arthurlleite/lulu-alimentador/documentacao/imagens/site-conectar.png

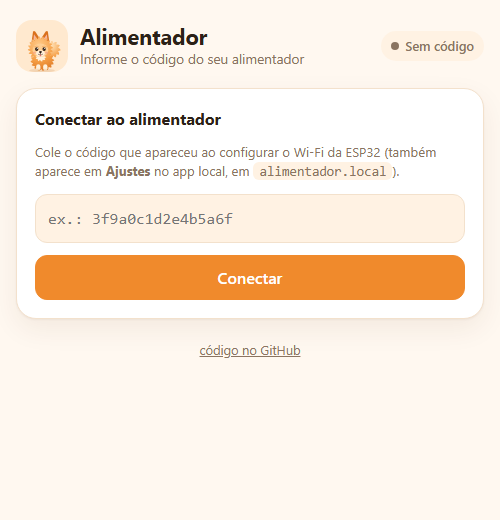
documentacao/imagens/site-conectar.png
