arthurlleite/lulu-alimentador/hardware/3d/imagens/eletronica_furacao.png

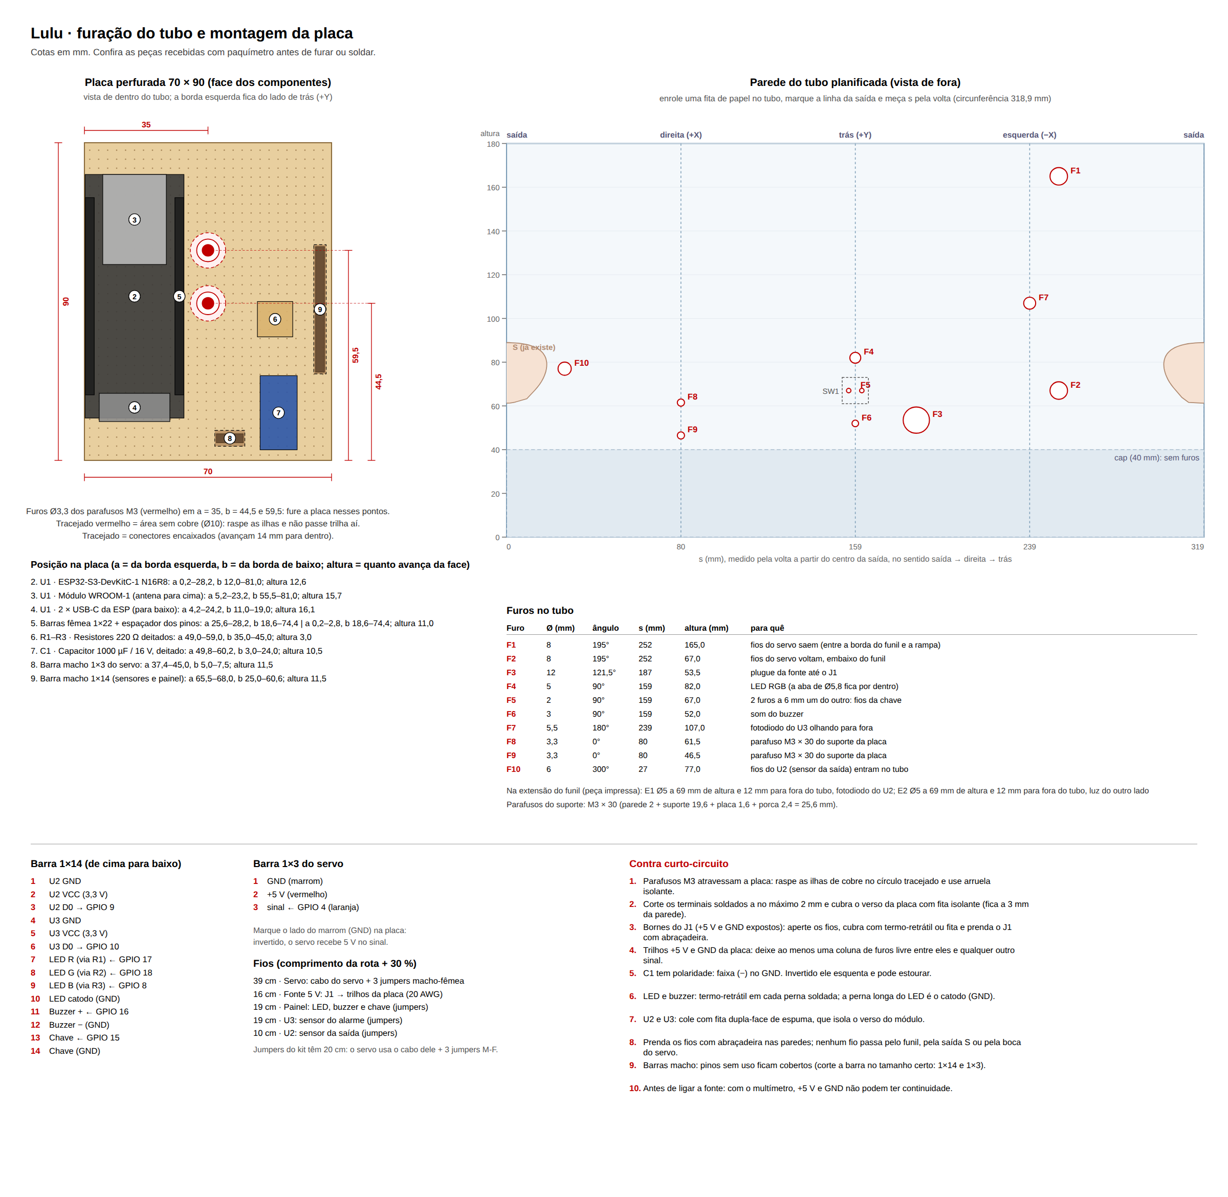
hardware/3d/imagens/eletronica_furacao.png
