arthurlleite/lulu-alimentador/hardware/3d/IoT3D.FCStd

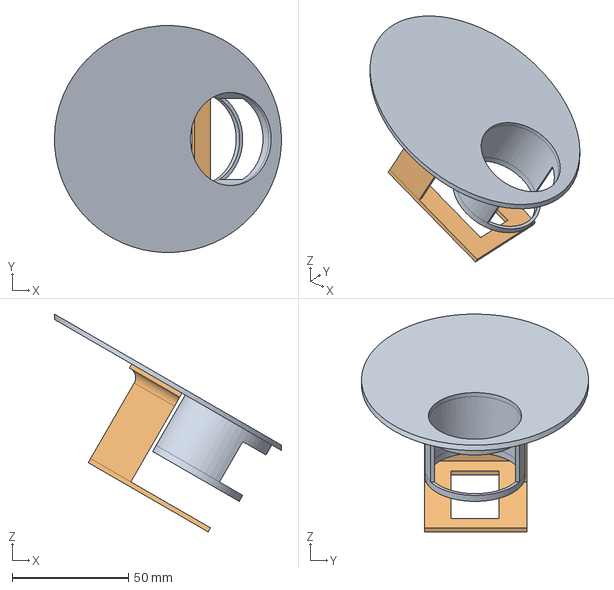
[picture p18: CAD file, 2026-10-22]
hardware/3d/IoT3D.FCStd
97.5 x 97.4 x 93.5 mm
superficie_inclinada
Suporte_motor
