arthurlleite/lulu-alimentador/hardware/3d/stl/tampa_atuador.stl

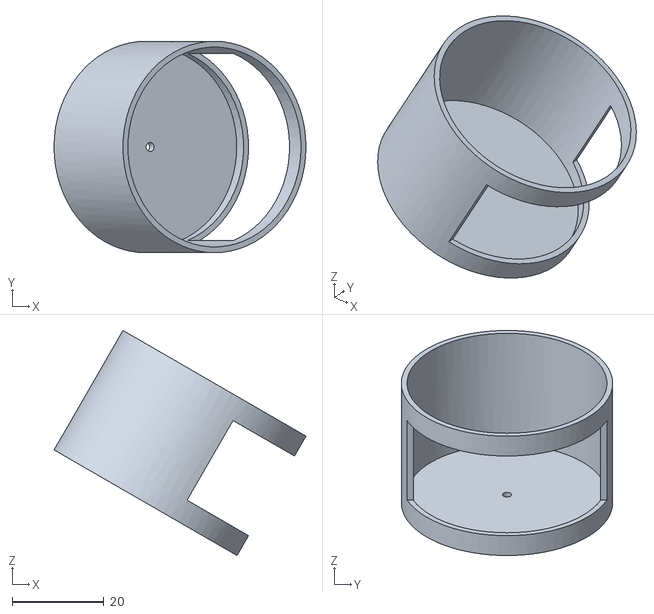
[picture p19: CAD file, 2026-10-22]
hardware/3d/stl/tampa_atuador.stl
54.8 x 46.0 x 49.0
