arthurlleite/lulu-alimentador/hardware/3d/stl/extensao_funil.stl

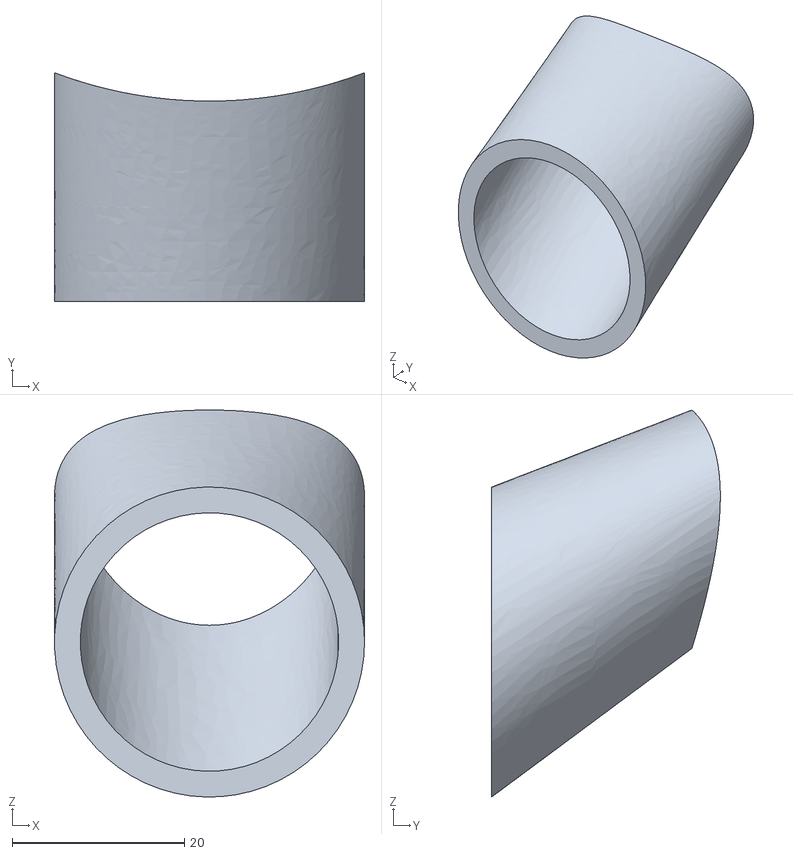
[picture p20: CAD file, 2026-10-22]
hardware/3d/stl/extensao_funil.stl
36.0 x 26.5 x 44.9
