arthurlleite/lulu-alimentador/hardware/3d/stl/funil_interno.stl

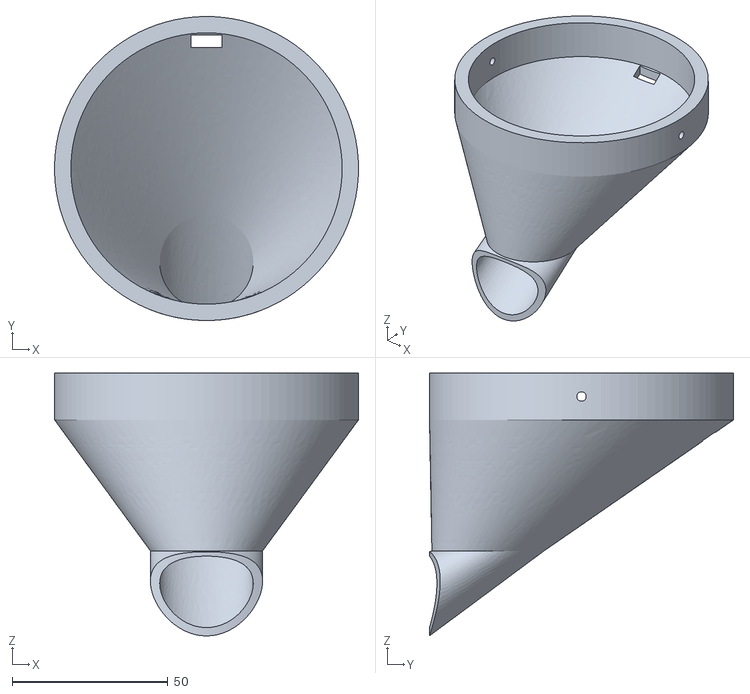
[picture p21: CAD file, 2026-10-22]
hardware/3d/stl/funil_interno.stl
97.5 x 97.5 x 84.3
