arthurlleite/lulu-alimentador/hardware/3d/stl/suporte_placa.stl

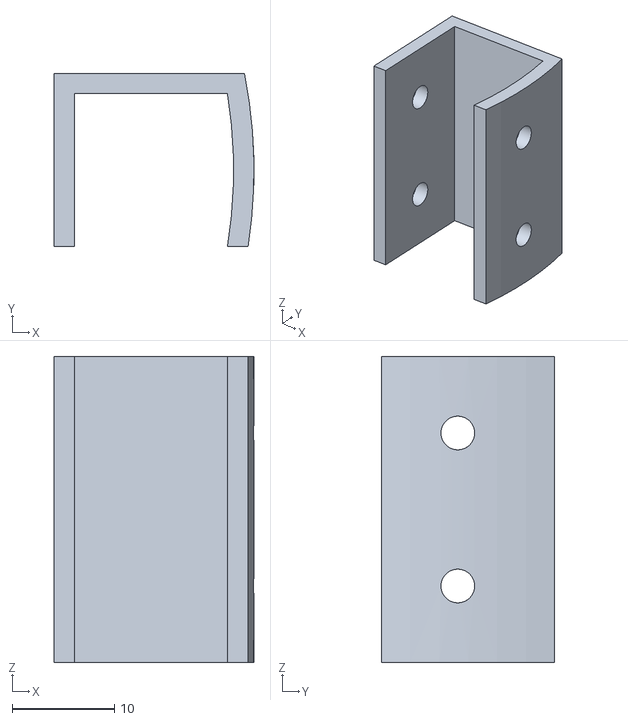
[picture p22: CAD file, 2026-10-22]
hardware/3d/stl/suporte_placa.stl
19.6 x 17.0 x 30.0
