arthurlleite/lulu-alimentador/hardware/3d/stl/suporte_rampa.stl

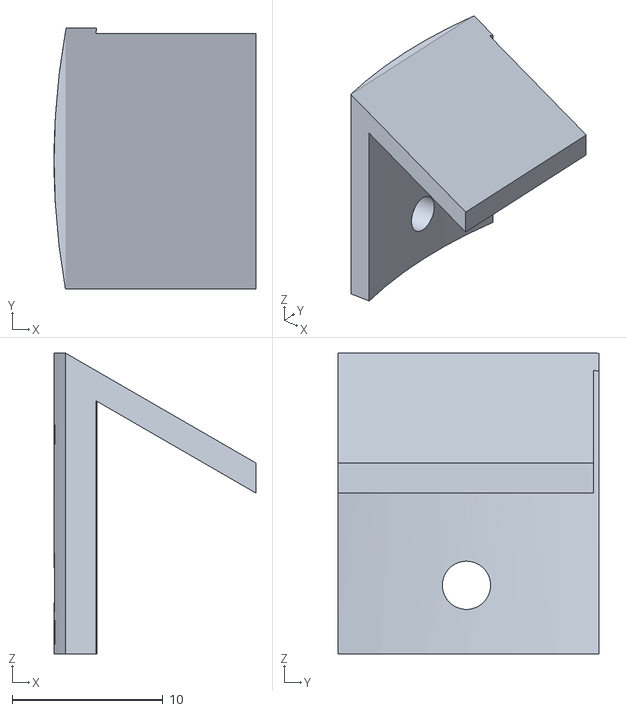
[picture p23: CAD file, 2026-10-22]
hardware/3d/stl/suporte_rampa.stl
13.4 x 17.4 x 20.0
