arthurlleite/lulu-alimentador/hardware/3d/stl/rampa_inclinada.stl

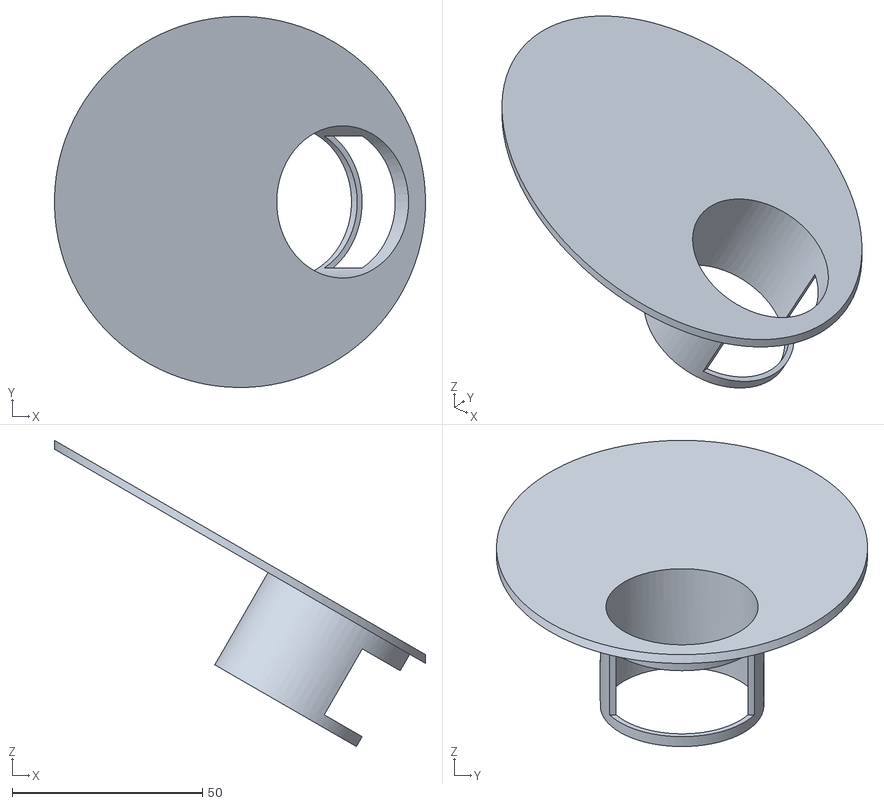
[picture p24: CAD file, 2026-10-22]
hardware/3d/stl/rampa_inclinada.stl
97.5 x 97.5 x 80.4
