arthurlleite/lulu-alimentador/hardware/3d/stl/tampa_tubo.stl

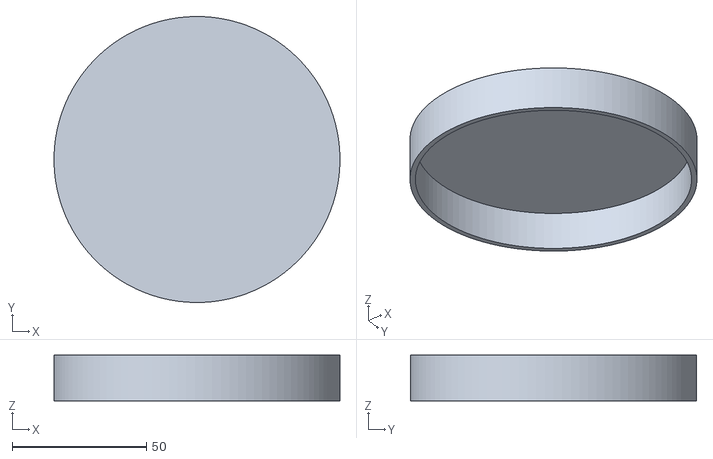
[picture p25: CAD file, 2026-10-22]
hardware/3d/stl/tampa_tubo.stl
106.5 x 106.5 x 17.0
