arthurlleite/lulu-alimentador/hardware/3d/stl/suporte_motor.stl

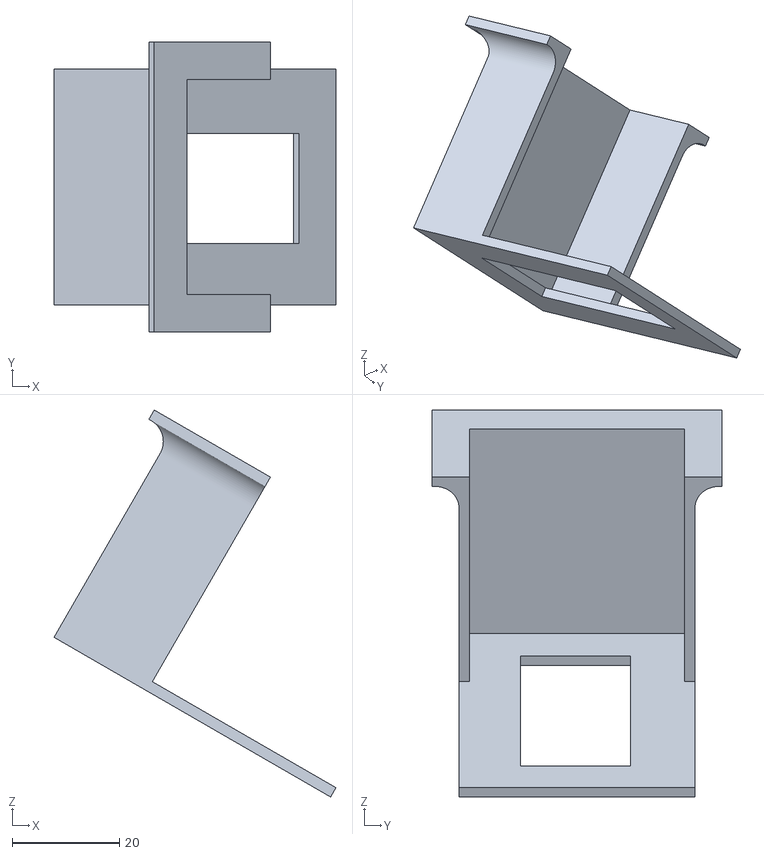
[picture p26: CAD file, 2026-10-22]
hardware/3d/stl/suporte_motor.stl
52.5 x 54.0 x 72.1
