arthurlleite/lulu-alimentador/firmware/src/dns_portal.h

#pragma once
// DNS "cativo": responde qualquer nome com 192.168.4.1 enquanto a rede de
// configuração está ativa, para o celular abrir a página sozinho.
void dns_portal_iniciar(void);
void dns_portal_parar(void);
