arthurlleite/lulu-alimentador/(commit log)

2026-10-22 Organiza o repositório por destino: firmware, web e hardware
    O modelo 3D vai para hardware/3d (o que vai para a impressora fica
    separado do código da ESP32). Remove os READMEs vazios do template do
    PlatformIO e as associações de arquivo do VS Code, e fixa LF como fim
    de linha para os arquivos embutidos no firmware.
2026-10-22 Migra o firmware para ESP-IDF 5 na pasta firmware/
    Base do novo firmware: PlatformIO com ESP-IDF 5.3 (espressif32 6.9.0)
    para ESP32-S3 DevKitC-1 e ESP32 clássica, tabela de partições com app
    de 1,875 MB (o TLS não cabe em 1 MB), pinos e parâmetros no menuconfig
    e o estado central (app.c), que guarda nome do pet, agenda e Wi-Fi na
    NVS e gera o JSON de status.
    Os módulos lib/my_* do projeto original são reescritos nos commits
    seguintes (servo, agenda, sensores e rede).
2026-10-22 Reescreve servo e agenda e adiciona LED RGB, buzzer e botão
    feeder: fila de refeições com struct própria (o original criava a fila
    com itens de 160 bytes e copiava para um int, corrompendo a pilha).
    Cada porção abre e fecha o servo como no my_servo.c, com PWM de 14 bits
    e sensor IR na saída: se nada cair, sacode e tenta de novo, e avisa.
    scheduler: até 8 horários com porções próprias, conferidos por minuto
    (o original dormia um tempo negativo com a agenda vazia).
    ui: LED RGB de status, buzzer que chama o pet antes de servir e botão
    (toque = 1 porção, 5 s = apagar o Wi-Fi).
2026-10-22 Adiciona sensores de nível (HC-SR04) e ambiente (DHT11)
    O ultrassom fica na tampa de cima e mede a distância até a ração
    (mediana de 5 leituras por causa dos ecos no tubo); vira porcentagem
    com a calibração vazio/cheio e gera o alarme de ração baixa. O DHT11
    mede temperatura e umidade dentro do reservatório.
2026-10-22 Reescreve a rede: portal de configuração, MQTT com TLS e app local
    wifi_mgr: sem Wi-Fi salvo, cria a rede Alimentador-XXXX com portal
    cativo (DNS próprio) onde se escolhe a rede e o nome do pet. Com Wi-Fi
    salvo, reconecta com espera crescente e reabre o portal se não
    conseguir. Deixa de imprimir a senha na serial.
    mqtt_link: broker público da HiveMQ via mqtts, tópico com código
    aleatório de 64 bits, estado retido e testamento online/offline. Trata
    o comando na hora em vez de repassar o buffer do cliente para outra
    tarefa.
    web_server: serve o app e a página de configuração embutidos na flash
    e a API /api/state, /api/cmd, /api/scan e /api/provision.
    commands: o mesmo JSON pelo MQ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
2026-10-22 Cria a arte do Lulu da Pomerânia para o ícone do app
    Desenho vetorial (SVG) gerado por tools/lulu.py, com versões PNG de 192
    e 512 px para instalar o app na tela inicial do celular. Substitui as
    imagens do projeto antigo.
2026-10-22 Refaz o app web: painel do pet, agenda e página de configuração
    index.html substitui a página Bootstrap + Paho do Firebase. O mesmo
    arquivo roda em dois modos: servido pela ESP32 (HTTP local, funciona
    sem internet) ou no GitHub Pages (MQTT via WebSocket seguro). Mostra
    nível de ração, próxima refeição, temperatura/umidade, histórico e
    alarmes; a agenda aceita até 8 horários com porções e liga/desliga.
    Tema claro/escuro automático e layout para celular.
    setup.html é a página do portal cativo: nome do pet, lista de redes
    com sinal e senha. No fim mostra o link pessoal de acesso remoto.
    manifest.webmanifest permite instalar como app no celular.
2026-10-22 Publica o app e um instalador de firmware no GitHub Pages
    O workflow compila o firmware das duas placas, junta bootloader,
    partições e app num .bin por placa e publica junto com a pasta web/.
    A página instalar.html usa o ESP Web Tools para gravar a ESP32 pelo
    Chrome/Edge, sem instalar PlatformIO. Em pull requests só compila.
2026-10-22 Traduz o firmware para português: arquivos, funções e menuconfig
    Módulos renomeados (dosador, agenda, sensores, interface, comandos,
    rede_wifi, dns_portal, servidor_web, nuvem_mqtt, estado), opções do
    menuconfig como CONFIG_ALIM_* e protocolo JSON em português
    ({"comando":"alimentar","porcoes":2}, tópicos /comando, /estado,
    /evento e rotas /api/estado, /api/comando, /api/redes, /api/configurar).
2026-10-22 Traduz o app web para português e usa o novo protocolo
    IDs, classes e variáveis em português; páginas e ícones renomeados
    (configurar.html, icone.svg) e links apontando para lulu-alimentador.
2026-10-22 Adiciona a lista de materiais com preços pesquisados
    Cada peça com quantidade, faixa de preço, link da loja onde foi
    cotada e o motivo da escolha, além da comparação entre placas ESP32.
2026-10-22 Exporta as peças 3D em STL com imagens e guia de impressão
    Oito peças imprimíveis tiradas do IoT3D.FCStd (rampa inclinada, tampa
    do atuador, suporte do motor, funil, extensão, tampa do tubo e dois
    suportes), renders de cada uma e da montagem, medidas, volume e
    configuração de impressão. ferramentas/exportar_3d.py regera os STL.
2026-10-22 Ajusta a lista de materiais às medidas do modelo 3D
    Tubo de 300 mm, um cap só (a tampa de cima é impressa), ~150 g de
    filamento e o MG996R confirmado pelo suporte do motor.
2026-10-22 Documenta o produto de referência (PETLIBRO Air PLAF108)
    Especificações oficiais, pinos levantados dos firmwares abertos,
    mapeamento função a função para o nosso alimentador, o que fica
    simplificado e outros produtos para o comparativo do Trabalho 2.
2026-10-22 Escreve o passo a passo de montagem e os problemas comuns
2026-10-22 Documenta a hospedagem gratuita e o fluxo app, broker e ESP32
2026-10-22 Adiciona prints do app local, modo escuro, configuração e instalador
2026-10-22 Reescreve o README em português com peças, preços e referência
    Apresenta o projeto, prints do app, como funciona, o produto de
    referência (PETLIBRO Air), a lista de compras com preços e links,
    as peças 3D, a organização das pastas, como começar, a história do
    projeto e a tabela da equipe da disciplina.
2026-10-22 Marca ESP32-S3, servo e fonte como itens que a equipe já possui
    Saem do total de compras, que fica em R$ 120 – 240.
2026-10-22 Descreve o HC-SR04 como item opcional na lista de materiais
2026-10-22 Simplifica a descrição dos parafusos na lista de materiais
2026-10-22 Adiciona o pré-esquemático da eletrônica (SVG e PNG)
    ESP32-S3 com os pinos usados, alimentação com o capacitor do servo,
    divisor do ECHO do HC-SR04, resistores do LED RGB e cada módulo com
    etiquetas de rede. Gerado por ferramentas/esquematico.py.
2026-10-22 Mostra o pré-esquemático no guia de eletrônica e no README
2026-10-29 Refaz o esquemático no padrão EasyEDA com as peças compradas
    Folha A4 com blocos por função, designadores, etiquetas de rede e lista de componentes. Entram os dois sensores de chama (saída da ração e alarme), o buzzer de 3,3 V direto no GPIO 16 e a fonte de 5 V / 5 A; saem o HC-SR04 e o DHT11. O guia de ligações acompanha o novo desenho.
2026-10-29 Adiciona o alarme de chama e desliga HC-SR04 e DHT11 por padrão
    O segundo sensor de chama (GPIO 10) tem tarefa própria: depois de 1 s vendo chama, o LED pisca vermelho, o buzzer bipa e o app recebe o evento. O alarme tem prioridade sobre os outros e some 5 s depois que a chama sai. O estado passa a informar quais sensores estão ligados, e o buzzer usa a força máxima do pino.
2026-10-29 Esconde no app os sensores desligados e mostra o aviso de chama
2026-10-29 Atualiza a lista de materiais com a compra e o rateio da eletrônica
2026-10-29 Desenha o posicionamento da eletrônica dentro do tubo
    Três vistas geradas a partir das coordenadas do IoT3D.FCStd, com medidas dos componentes, altura de cada furo e conferência de colisão com as peças impressas. O mesmo script, rodado como macro no FreeCAD, adiciona as peças ao grupo Eletronica.
2026-10-29 Ajusta firmware, referência comercial e montagem aos sensores atuais
2026-10-29 Calcula folgas, fios e furação da eletrônica dentro do tubo
    As medidas dos componentes passam a ser envelopes: a maior medida publicada entre as variantes de cada peça (ESP32-S3 de até 69 × 28 mm, capacitor Ø10,5 × 21, conector P4 com borne 35 × 17 × 15 etc.). O script exige 3 mm de folga entre componentes, funil e parede, e confere a rota de cada fio, inclusive o giro da boca do servo.
    A placa encosta na aba lisa do suporte, com os parafusos M3 nos furos medidos no STL. Nova folha de furação: placa com cotas, parede planificada com os furos F1 a F10, mapa das barras 1×14 e 1×3, comprimento dos fios e checklist contra curto-circuito.
